NicoSorren/Extrusora-Filamento-PET/PET_Extruder/diagrama_main_loop.pdf

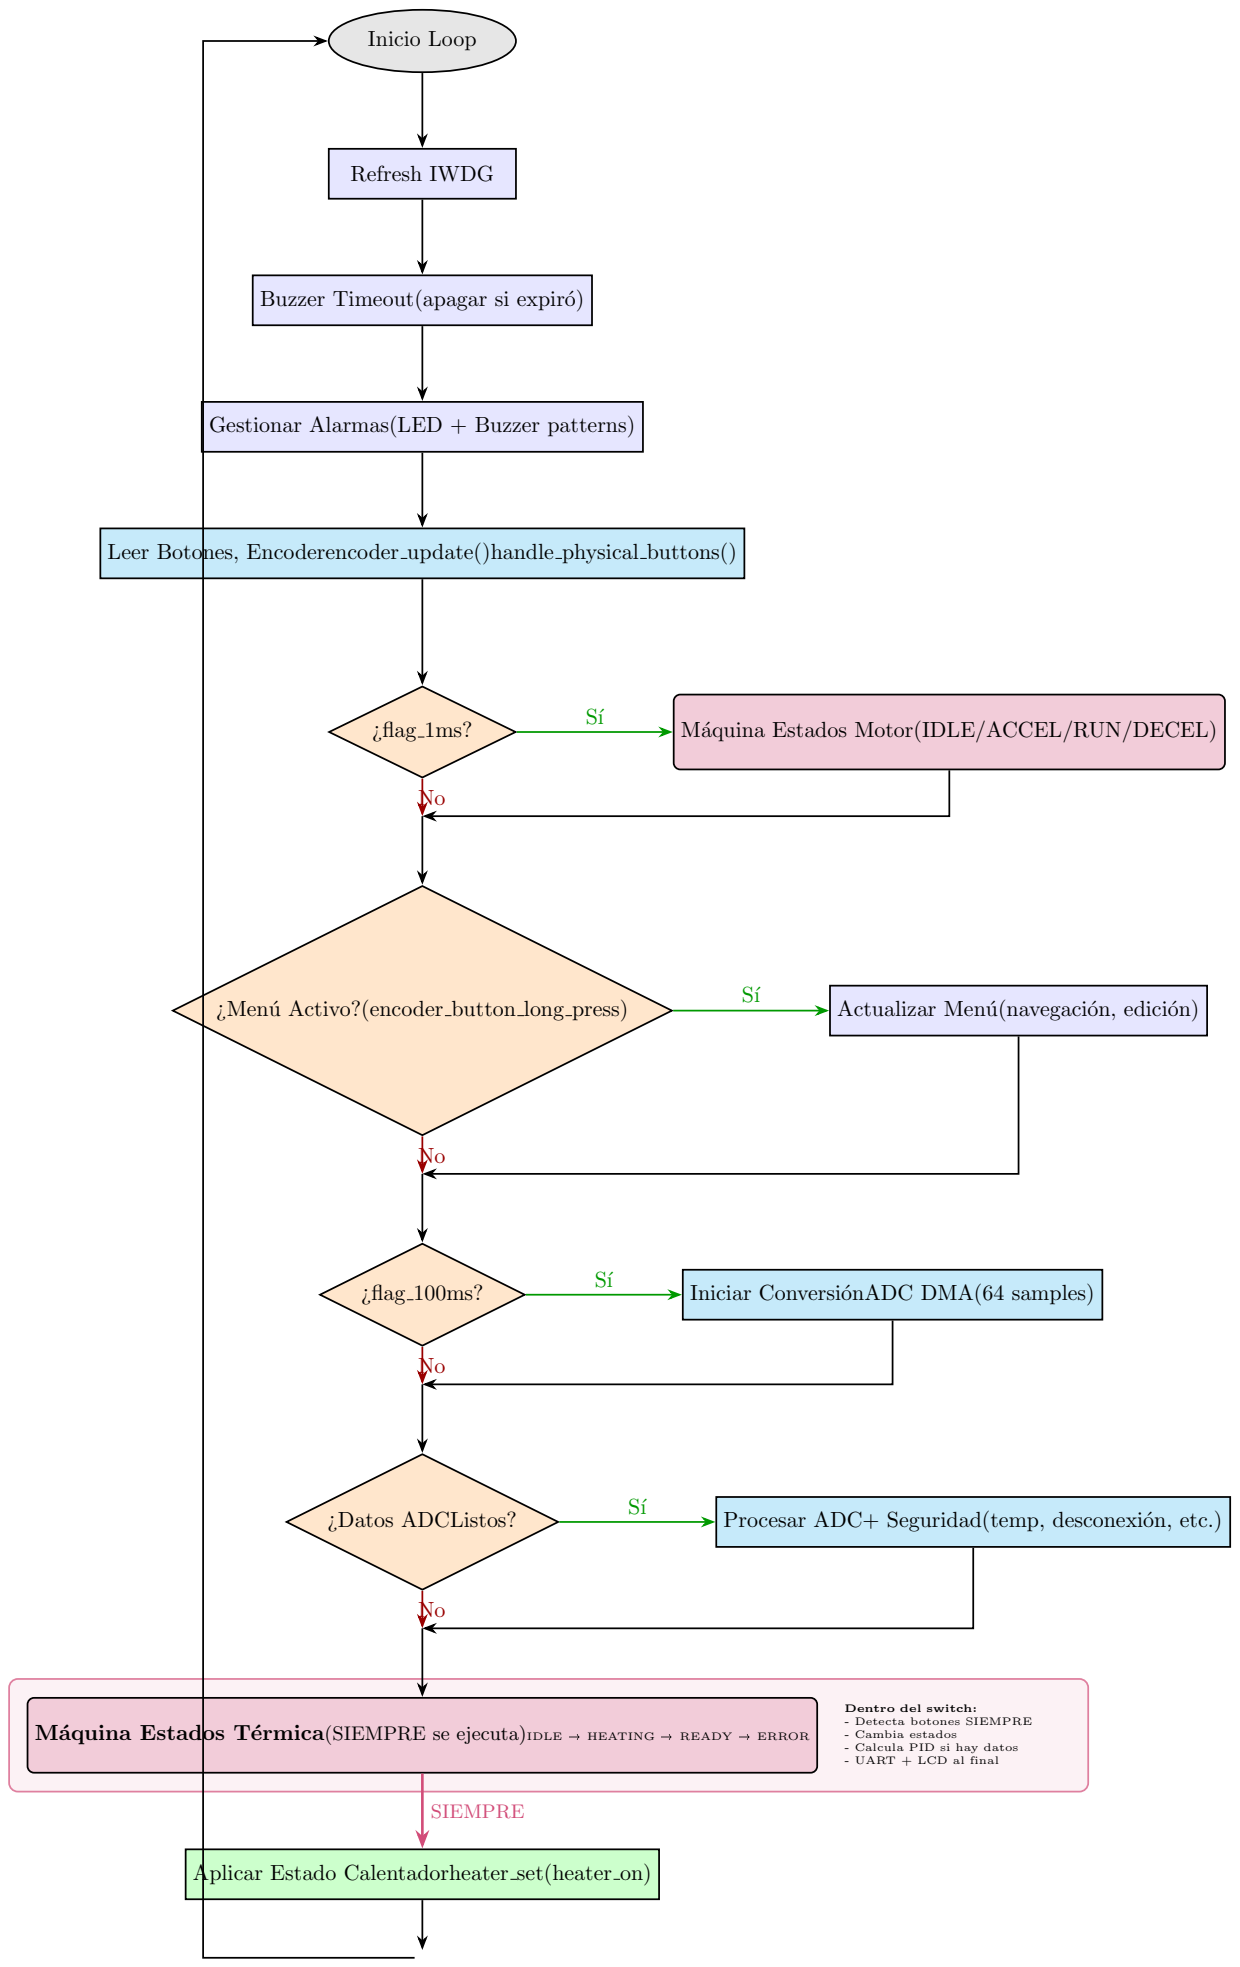
[picture p4: page 1]
Inicio Loop; Refresh IWDG; ¿flag 1ms?; M´aquina Estados Motor(IDLE/ACCEL/RUN/DECEL); ¿Men´u Activo?(encoder button long press); Actualizar Men´u(navegaci´on, edici´on); ¿flag 100ms?; Iniciar Conversi´onADC DMA(64 samples); ¿Datos ADCListos?; Procesar ADC+ Seguridad(temp, desconexi´on, etc.); SIEMPRE

Buzzer Timeout(apagar si expir´o)

Gestionar Alarmas(LED + Buzzer patterns)

Leer Botones, Encoderencoder update()handle physical buttons()

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

M´aquina Estados T´ermica(SIEMPRE se ejecuta)IDLE  HEATING  READY  ERROR

Aplicar Estado Calentadorheater set(heater on)
