NicoSorren/Extrusora-Filamento-PET/PET_Extruder/Core/Inc/main.h

#define DIR_Pin GPIO_PIN_1
#define DIR_GPIO_Port GPIOA
#define BUZZER_Pin GPIO_PIN_2
#define BUZZER_GPIO_Port GPIOA
#define RGB_B_Pin GPIO_PIN_3
#define RGB_B_GPIO_Port GPIOA
#define START_BTN_Pin GPIO_PIN_4
#define START_BTN_GPIO_Port GPIOA
#define MOTOR_EN_Pin GPIO_PIN_5
#define MOTOR_EN_GPIO_Port GPIOA
#define RGB_R_Pin GPIO_PIN_0
#define RGB_R_GPIO_Port GPIOB
#define RGB_G_Pin GPIO_PIN_1
#define RGB_G_GPIO_Port GPIOB
#define HEATER_BTN_Pin GPIO_PIN_11
#define HEATER_BTN_GPIO_Port GPIOB
#define STOP_BTN_Pin GPIO_PIN_12
#define STOP_BTN_GPIO_Port GPIOB
#define ENC_SW_Pin GPIO_PIN_13
#define ENC_SW_GPIO_Port GPIOB
#define ENC_SW_EXTI_IRQn EXTI15_10_IRQn
#define ENC_CLK_Pin GPIO_PIN_14
#define ENC_CLK_GPIO_Port GPIOB
#define ENC_CLK_EXTI_IRQn EXTI15_10_IRQn
#define ENC_DT_Pin GPIO_PIN_15
#define ENC_DT_GPIO_Port GPIOB
#define DRV_FAULT_Pin GPIO_PIN_11
#define DRV_FAULT_GPIO_Port GPIOA
#define DRV_FAULT_EXTI_IRQn EXTI15_10_IRQn
#define HEATER_EN_Pin GPIO_PIN_8
#define HEATER_EN_GPIO_Port GPIOB
