NicoSorren/Extrusora-Filamento-PET/ptf/Core/Src/main1.c

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
/* Includes ------------------------------------------------------------------*/
#include "main.h"

/* USER CODE BEGIN Includes */
#include "st7789.h"
#include "fonts.h"
#include "Menu.h"
#include <stdint.h>
#include "Thermistor.h"
#include "Buzzer.h"
#include "pid.h"
/* USER CODE END Includes */

/* USER CODE BEGIN PD */

volatile int32_t previous_counter=0;
volatile int32_t counterx=0;
volatile int32_t countery=0;
volatile int8_t ESW_Flag=0;//Encoder Switch Flag

uint16_t adc_value = 0;  //Variables For Reading The Thermistor
float temperature = 0.0;

volatile uint8_t page=0;//For Navigating The Menu
volatile uint8_t edit_mode = 0;// Flags...
volatile uint8_t START_flag = 0;
volatile uint8_t Heat_flag = 0;
volatile uint8_t Heat_Start_Flag=0;
volatile uint8_t protection_flag=0;

uint16_t Target_Temperature=260; // Memory Temp
uint8_t  Speed=50; // Memory Speed
uint8_t  Buzzer_State=1; // Memory Buzzer State
uint8_t  Switch_State=0; // Memory Switch State

uint8_t END_STOP_FLAG=0;// Filament run out detection flag

PID_TypeDef HeaterPID;
double input_temp, output_pwm, setpoint_temp;

/* USER CODE END PD */

ADC_HandleTypeDef hadc;

SPI_HandleTypeDef hspi1;
DMA_HandleTypeDef hdma_spi1_tx;

TIM_HandleTypeDef htim1;
TIM_HandleTypeDef htim2;
TIM_HandleTypeDef htim3;

void SystemClock_Config(void);
static void MX_GPIO_Init(void);
static void MX_DMA_Init(void);
static void MX_SPI1_Init(void);
static void MX_TIM1_Init(void);
static void MX_ADC_Init(void);
static void MX_TIM2_Init(void);
static void MX_TIM3_Init(void);
/* USER CODE BEGIN 0 */

void HAL_TIM_IC_CaptureCallback(TIM_HandleTypeDef *htim) //Reading Rotary Encoder...
{
    if (htim->Instance == TIM2) {

       int32_t current_counter = __HAL_TIM_GET_COUNTER(htim);
       int32_t delta = current_counter - previous_counter;

		if (delta > 32767) delta -= 65536;
		else if (delta < -32768) delta += 65536;

		counterx += delta;
		countery = counterx/2;
		previous_counter = current_counter;

		if(page==1 && START_flag==0 && Heat_flag==0){
		   if(countery>2){ countery=0; counterx=0;}
		   if(countery<0){ countery=2; counterx=2*2;}
		   mm_selection_indicator(countery);  // Update indicator
		}

		if(page==1 && START_flag==0 && Heat_flag==1){
			if (countery > 1) { countery = 0; counterx = 0; }
			if (countery < 0) { countery = 1; counterx = 1 * 2; }
			mm_selection_indicator(countery); // Update indicator
		}

        if(page==2 && edit_mode==0){
            if (countery > 4) { countery = 0; counterx = 0; }
            if (countery < 0) { countery = 4; counterx = 4 * 2; }
            sm_selection_indicator(countery); // Update indicator
        }
}    }

void HAL_GPIO_EXTI_Callback(uint16_t GPIO_Pin) //Reading Button...
{

	 if (GPIO_Pin == GPIO_PIN_2) // PA2 = EXTI2
	    {
	        static uint32_t last_press = 0;
	        uint32_t now = HAL_GetTick();

	        if (now - last_press > 200)
	        {
	            ESW_Flag = 1;
	            last_press = now;
	        }
	    }

}

void Stepper_SetSpeed(uint8_t speed) {// Adjust the PWM frequency to control the stepper
    uint32_t freq = speed * 10;// Value we read from the menu * 10
    uint32_t timer_clock = 48000000; // 48 MHz system clock!!
    uint32_t prescaler = 48 - 1;     // 1 MHz timer tick
    uint32_t period = (1000000 / freq) - 1;

    __HAL_TIM_SET_PRESCALER(&htim1, prescaler);
    __HAL_TIM_SET_AUTORELOAD(&htim1, period);
    __HAL_TIM_SET_COMPARE(&htim1, TIM_CHANNEL_2, period / 2); // 50% duty
}

void Stepper_SoftStart(uint8_t targetSpeed)// Soft starting stepper
{
    uint8_t currentSpeed = 2;  // starting from very slow
    uint8_t step = 2;           // speed increment per step
    uint8_t delay = 50;         // ms delay between increments

    while (currentSpeed < targetSpeed)
    {
        Stepper_SetSpeed(currentSpeed);
        HAL_TIM_PWM_Start(&htim1, TIM_CHANNEL_2);
        HAL_Delay(delay);
        currentSpeed += step;
    }

    // Final target speed
    Stepper_SetSpeed(targetSpeed);
}

void Heater_SetPower(float duty)// Control the PWM of the MOSFET...
{
    // Clamp duty cycle between 0–100%
    if (duty < 0.0f) duty = 0.0f;
    if (duty > 100.0f) duty = 100.0f;

    // Get the timer period (ARR)
    uint32_t period = __HAL_TIM_GET_AUTORELOAD(&htim3);

    // Calculate the compare value based on duty %
    uint32_t compare = (uint32_t)((duty / 100.0f) * period);

    // Apply new PWM duty
    __HAL_TIM_SET_COMPARE(&htim3, TIM_CHANNEL_1, compare);
}


/* USER CODE END 0 */

/**
  * @brief  The application entry point.
  * @retval int
  */
int main(void)
{

  /* MCU Configuration--------------------------------------------------------*/

  /* Reset of all peripherals, Initializes the Flash interface and the Systick. */
  HAL_Init();

  /* Configure the system clock */
  SystemClock_Config();

  /* Initialize all configured peripherals */
  MX_GPIO_Init();
  MX_DMA_Init();
  MX_SPI1_Init();
  MX_TIM1_Init();
  MX_ADC_Init();
  MX_TIM2_Init();
  MX_TIM3_Init();
  /* USER CODE BEGIN 2 */
  HAL_TIM_Encoder_Start_IT(&htim2, TIM_CHANNEL_ALL);
  HAL_TIM_PWM_Start(&htim3, TIM_CHANNEL_1);
  ST7789_Init();
  opening_melody();// Play the melody while opening
  main_menu();// Call the main menu

  HAL_GPIO_WritePin(DIR_GPIO_Port, DIR_Pin, 1); //Direction of the stepper...
  HAL_GPIO_WritePin(EN_GPIO_Port, EN_Pin, 1);// Disable stepper driver...

  setpoint_temp = Target_Temperature;   // Desired temp (°C)
  input_temp = temperature;              // Initial temperature reading
  output_pwm = 0.0;                      // Start with no heater power

  PID(&HeaterPID, &input_temp, &output_pwm, &setpoint_temp,
      0.8, 0.006, 0.7,                   // Tune for better results...
      _PID_P_ON_E, _PID_CD_DIRECT);     // Standard direct control

  PID_SetOutputLimits(&HeaterPID, 0, 100);    // PWM % output limit
  PID_SetMode(&HeaterPID, _PID_MODE_AUTOMATIC);

  /* USER CODE END 2 */

  /* Infinite loop */
  /* USER CODE BEGIN WHILE */
  while (1)
  {

	HAL_Delay(250);


	END_STOP_FLAG = HAL_GPIO_ReadPin(EndSW_GPIO_Port, EndSW_Pin);
	adc_value = Read_ADC_Channel(&hadc);
	temperature = Get_Temperature(adc_value);

	if(page==1){ // Refresh the readings once in a while
	mm_values((uint16_t)temperature, Target_Temperature, Speed);
	}
	if(page==2){ // Refresh the readings once in a while
	settings_values(Target_Temperature, Speed, Buzzer_State, Switch_State);
	}


/*--------------------------------------------------------------------------------*/
// Main Menu Section
/*--------------------------------------------------------------------------------*/// Start Option
	if((ESW_Flag==1 && countery==0 && page==1 && Heat_flag==0 && START_flag==0) || Heat_Start_Flag==1){   //START
		ESW_Flag=0;
		Heat_Start_Flag=0;
		START_flag=1;
		HAL_GPIO_WritePin(EN_GPIO_Port, EN_Pin, 0);// Enable stepper driver
		ST7789_WriteString(60, 135, "Starting", Font_16x26, WHITE, BLACK);
		start_melody();
		ST7789_WriteString(60, 135, "        ", Font_16x26, WHITE, BLACK);
		if(temperature >= Target_Temperature - 10){
		Stepper_SoftStart(Speed);
		}

	}
	if(START_flag==1){
		ST7789_WriteString(88, 135, "Stop ", Font_16x26, WHITE, BLACK);

		adc_value = Read_ADC_Channel(&hadc);
		temperature = Get_Temperature(adc_value);
		mm_values((uint16_t)temperature, Target_Temperature, Speed);

		input_temp = temperature;             // Current temperature
		setpoint_temp = Target_Temperature;   // Target

		if (PID_Compute(&HeaterPID))
		{
		    Heater_SetPower(output_pwm);      // Apply PID output to heater PWM

		}

		if(temperature >= Target_Temperature - 4){ // If the measured temperature is bigger then target only than start the stepper...
		Stepper_SetSpeed(Speed);
		HAL_TIM_PWM_Start(&htim1, TIM_CHANNEL_2);
		protection_flag=1;
		}

		if((temperature <= Target_Temperature - 15) && protection_flag==1){ // PID values might be too small or there might be a heating problem, stop the stepper...
		protection_flag=0;
		}

		if((END_STOP_FLAG == 0 && Switch_State == 1) || protection_flag==0 ){ // If the filament runs out or nozzle too cold

			START_flag = 0;// Stop the machine when the filament runs out

			__HAL_TIM_SET_COUNTER(&htim2, 0);
			counterx = 0;
			countery = 0;
			previous_counter = 0;
			mm_selection_indicator(countery);

			HAL_TIM_PWM_Stop(&htim1, TIM_CHANNEL_2);     //Stop stepper
            HAL_GPIO_WritePin(EN_GPIO_Port, EN_Pin, 1);

            Heater_SetPower(0); //Stop heater
            output_pwm = 0.0;
            ST7789_WriteString(80, 135, "Start", Font_16x26, WHITE, BLACK);
            stop_melody();

		}


		if (ESW_Flag == 1) { // If user clicks Stop
			ESW_Flag = 0;
			START_flag = 0;

			__HAL_TIM_SET_COUNTER(&htim2, 0);
			counterx = 0;
			countery = 0;
			previous_counter = 0;
			mm_selection_indicator(countery);

		    HAL_TIM_PWM_Stop(&htim1, TIM_CHANNEL_2);     //Stop stepper
			HAL_GPIO_WritePin(EN_GPIO_Port, EN_Pin, 1);

			Heater_SetPower(0); //Stop heater
			output_pwm = 0.0;

			ST7789_WriteString(80, 135, "Start", Font_16x26, WHITE, BLACK);
			short_stop_melody();
    }}

/*--------------------------------------------------------------------------------*/// Pre-heat Option
	if(ESW_Flag==1 && countery==1 && page==1 && START_flag==0 && Heat_flag==0){  // Enter Pre-Heat mode
	    ESW_Flag=0;
	    Heat_flag=1;
	    ST7789_WriteString(56, 170, "  ", Font_16x26, WHITE, BLACK);
	    ST7789_WriteString(76, 170, "Cancel ", Font_16x26, WHITE, BLACK);
	    start_melody();
	}
	if (Heat_flag == 1) {

		input_temp = temperature;             // Current temperature
		setpoint_temp = Target_Temperature;   // Target

		if (PID_Compute(&HeaterPID))
		{
			Heater_SetPower(output_pwm);      // Apply PID output to heater PWM
		}

		if(temperature>=Target_Temperature - 4){
			protection_flag=1;
		}

	    if (ESW_Flag == 1 && countery == 0) { // Start
	    	ST7789_WriteString(56, 170, "Pre-Heat", Font_16x26, WHITE, BLACK);
	    	Heat_Start_Flag=1;
	    	ESW_Flag=0;
	        Heat_flag = 0;
	        START_flag = 1;

	        __HAL_TIM_SET_COUNTER(&htim2, 0);
	        counterx = 0;
	        countery = 0;
	        previous_counter = 0;
	        mm_selection_indicator(countery);
	    }

	    if (ESW_Flag == 1 && countery == 1) { // Cancel
	        ESW_Flag = 0;
	        Heat_flag = 0;

	        Heater_SetPower(0); //Stop heater
	        output_pwm = 0.0;

			__HAL_TIM_SET_COUNTER(&htim2, 0);
			counterx = 0;
			countery = 0;
			previous_counter = 0;
			mm_selection_indicator(countery);

	        ST7789_WriteString(56, 170, "Pre-Heat", Font_16x26, WHITE, BLACK);
	        short_stop_melody();
	}}

/*--------------------------------------------------------------------------------*/// Settings Option
	if(ESW_Flag==1 && countery==2 && page==1){  //Settings
	   ESW_Flag=0;
	   START_flag=0;
	   Heat_flag=0;
	   settings_melody();
	   settings_menu();

	   __HAL_TIM_SET_COUNTER(&htim2, 0);  // Reset encoder hardware counter
	   previous_counter = 0;
	   counterx = 0;
	   countery = 0;

    }



/*--------------------------------------------------------------------------------*/
// Settings Menu Section
/*--------------------------------------------------------------------------------*/// Temperature Edit
	if (ESW_Flag == 1 && countery == 0 && page == 2) {  // Temp edit mode
	    ESW_Flag = 0;
	    edit_mode = 1;

	    uint16_t temp_edit = Target_Temperature;  // Start from current
	    int16_t base_counter = countery;           // Remember where encoder was

	    while (edit_mode == 1) {
	    	HAL_Delay(100);
	        // Calculate movement relative to entry position
	        int16_t diff = countery - base_counter;

	        if (diff != 0) {
	            temp_edit += diff;        // apply movement
	            base_counter = countery;  // update baseline
	        }

	        if (temp_edit > 260) temp_edit = 260; // Clamp value to limits
	        if (temp_edit < 180) temp_edit = 180;

	        // Show on screen
	        settings_values(temp_edit, Speed, Buzzer_State, Switch_State);

	        if (ESW_Flag == 1) { // Save if button pressed
	            ESW_Flag = 0;
	            Target_Temperature = temp_edit;
	            edit_mode = 0;
	            counterx = 0;
	            countery = 0;// reset encoder for next use
	}}}

/*--------------------------------------------------------------------------------*/// Speed Edit
	if (ESW_Flag == 1 && countery == 1 && page == 2) {  // Speed edit mode
	    ESW_Flag = 0;
	    edit_mode = 1;

	    uint8_t temp_speed = Speed;       // Start from current Speed
	    int16_t base_counter = countery;  // Remember current encoder position

	    while (edit_mode == 1) {
	        HAL_Delay(100);

	        // Calculate encoder movement
	        int16_t diff = countery - base_counter;

	        if (diff != 0) {
	            temp_speed += diff;        // Adjust speed
	            base_counter = countery;   // Update baseline
	        }

	        // Clamp speed to safe limits
	        if (temp_speed > 100) temp_speed = 100;
	        if (temp_speed < 4)  temp_speed = 4;

	        // Update display live
	        settings_values(Target_Temperature, temp_speed, Buzzer_State, Switch_State);

	        // Save and exit on button press
	        if (ESW_Flag == 1) {
	            ESW_Flag = 0;
	            Speed = temp_speed;
	            edit_mode = 0;
	            counterx = 1*2; // Reset encoder for next use
	            countery = 1;
    }}}

/*--------------------------------------------------------------------------------*/// Buzzer Edit
	if (ESW_Flag == 1 && countery == 2 && page == 2) {  // Buzzer edit
	    ESW_Flag = 0;
	    edit_mode = 1;

	    while (edit_mode == 1) {
	        HAL_Delay(100);

	        // Toggle buzzer with encoder rotation
	        if (countery != 2) {        // user rotated encoder
	            Buzzer_State = !Buzzer_State;
	            countery = 2;           // reset back to its menu slot
	            settings_values(Target_Temperature, Speed, Buzzer_State, Switch_State);
	        }

	        if (ESW_Flag == 1) {// Exit on button press
	            ESW_Flag = 0;
	            edit_mode = 0;
	            counterx = 2*2;
	            countery = 2;
	}}}

/*--------------------------------------------------------------------------------*/// Switch Edit
	if (ESW_Flag == 1 && countery == 3 && page == 2) {  // Switch edit
	    ESW_Flag = 0;
	    edit_mode = 1;

	    while (edit_mode == 1) {
	        HAL_Delay(100);

	        // Toggle switch with encoder rotation
	        if (countery != 3) {        // user rotated encoder
	            Switch_State = !Switch_State;
	            countery = 3;           // reset position
	            settings_values(Target_Temperature, Speed, Buzzer_State, Switch_State);
	        }

	        if (ESW_Flag == 1) {// Exit on button press
	            ESW_Flag = 0;
	            edit_mode = 0;
	            counterx = 4*2;
	            countery = 4;
	 }}}

/*--------------------------------------------------------------------------------*/// Save and go back to main menu
	if(ESW_Flag==1 && countery==4 && page==2){  //Save & Back
	   ESW_Flag=0;
	   settings_melody();
	   main_menu();
	   __HAL_TIM_SET_COUNTER(&htim2, 0);  // Reset encoder hardware counter
	   previous_counter = 0;
	   counterx = 0;
	   countery = 0;
	}


    /* USER CODE END WHILE */

    /* USER CODE BEGIN 3 */
  }
  /* USER CODE END 3 */
}

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
