NicoSorren/Extrusora-Filamento-PET/ptf/Core/Inc/Buzzer.h

/*
 * Buzzer.h
 *
 *  Created on: Nov 10, 2025
 *      Author: Alper
 */

#ifndef INC_BUZZER_H_
#define INC_BUZZER_H_


void opening_melody();
void start_melody();
void stop_melody();
void short_stop_melody();
void settings_melody();
#endif /* INC_BUZZER_H_ */
