NicoSorren/Extrusora-Filamento-PET/ptf/Core/Src/Buzzer.c

/*
 * Buzzer.c
 *
 *  Created on: Nov 10, 2025
 *      Author: Alper
 */

#include "main.h"


void opening_melody()
{
if(Buzzer_State==1){
    HAL_GPIO_WritePin(Buzzer_GPIO_Port, Buzzer_Pin, GPIO_PIN_SET);
    HAL_Delay(80);
    HAL_GPIO_WritePin(Buzzer_GPIO_Port, Buzzer_Pin, GPIO_PIN_RESET);
    HAL_Delay(40);

    HAL_GPIO_WritePin(Buzzer_GPIO_Port, Buzzer_Pin, GPIO_PIN_SET);
    HAL_Delay(80);
    HAL_GPIO_WritePin(Buzzer_GPIO_Port, Buzzer_Pin, GPIO_PIN_RESET);
    HAL_Delay(40);

    HAL_GPIO_WritePin(Buzzer_GPIO_Port, Buzzer_Pin, GPIO_PIN_SET);
    HAL_Delay(100);
    HAL_GPIO_WritePin(Buzzer_GPIO_Port, Buzzer_Pin, GPIO_PIN_RESET);
    HAL_Delay(50);

    HAL_GPIO_WritePin(Buzzer_GPIO_Port, Buzzer_Pin, GPIO_PIN_SET);
    HAL_Delay(150);
    HAL_GPIO_WritePin(Buzzer_GPIO_Port, Buzzer_Pin, GPIO_PIN_RESET);
}}


void start_melody(){
	if(Buzzer_State==1){
	HAL_GPIO_WritePin(Buzzer_GPIO_Port, Buzzer_Pin, GPIO_PIN_SET);
	HAL_Delay(50);
	HAL_GPIO_WritePin(Buzzer_GPIO_Port, Buzzer_Pin, GPIO_PIN_RESET);
	HAL_Delay(50);
	HAL_GPIO_WritePin(Buzzer_GPIO_Port, Buzzer_Pin, GPIO_PIN_SET);
	HAL_Delay(50);
	HAL_GPIO_WritePin(Buzzer_GPIO_Port, Buzzer_Pin, GPIO_PIN_SET);
	HAL_Delay(50);
	HAL_GPIO_WritePin(Buzzer_GPIO_Port, Buzzer_Pin, GPIO_PIN_RESET);
}}

void settings_melody(){
	HAL_GPIO_WritePin(Buzzer_GPIO_Port, Buzzer_Pin, GPIO_PIN_SET);
	HAL_Delay(50);
	HAL_GPIO_WritePin(Buzzer_GPIO_Port, Buzzer_Pin, GPIO_PIN_RESET);
	HAL_Delay(50);
}

void stop_melody(){
	if(Buzzer_State==1){
	HAL_GPIO_WritePin(Buzzer_GPIO_Port, Buzzer_Pin, GPIO_PIN_SET);
    HAL_Delay(500);
    HAL_GPIO_WritePin(Buzzer_GPIO_Port, Buzzer_Pin, GPIO_PIN_RESET);
    HAL_Delay(1000);

	HAL_GPIO_WritePin(Buzzer_GPIO_Port, Buzzer_Pin, GPIO_PIN_SET);
    HAL_Delay(500);
    HAL_GPIO_WritePin(Buzzer_GPIO_Port, Buzzer_Pin, GPIO_PIN_RESET);
    HAL_Delay(1000);

	HAL_GPIO_WritePin(Buzzer_GPIO_Port, Buzzer_Pin, GPIO_PIN_SET);
    HAL_Delay(500);
    HAL_GPIO_WritePin(Buzzer_GPIO_Port, Buzzer_Pin, GPIO_PIN_RESET);
    HAL_Delay(1000);
}}

void short_stop_melody(){
	if(Buzzer_State==1){
	HAL_GPIO_WritePin(Buzzer_GPIO_Port, Buzzer_Pin, GPIO_PIN_SET);
	HAL_Delay(50);
	HAL_GPIO_WritePin(Buzzer_GPIO_Port, Buzzer_Pin, GPIO_PIN_RESET);
	HAL_Delay(100);
	HAL_GPIO_WritePin(Buzzer_GPIO_Port, Buzzer_Pin, GPIO_PIN_SET);
	HAL_Delay(50);
	HAL_GPIO_WritePin(Buzzer_GPIO_Port, Buzzer_Pin, GPIO_PIN_RESET);
	HAL_Delay(100);
	HAL_GPIO_WritePin(Buzzer_GPIO_Port, Buzzer_Pin, GPIO_PIN_SET);
	HAL_Delay(50);
	HAL_GPIO_WritePin(Buzzer_GPIO_Port, Buzzer_Pin, GPIO_PIN_RESET);
	HAL_Delay(100);
}}
