NicoSorren/Extrusora-Filamento-PET/Temp_Prueba/Core/Src/main.c

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
/* Includes ------------------------------------------------------------------*/
#include "main.h"
#include "adc.h"
#include "dma.h"
#include "i2c.h"
#include "tim.h"
#include "usart.h"
#include "gpio.h"

/* USER CODE BEGIN Includes */
#include "i2c-lcd.h"
#include <stdio.h>
#include <math.h>
#include <string.h>
#include <stdbool.h>
/* USER CODE END Includes */

/* USER CODE BEGIN PD */
// --- NTC y divisor (pull-up: Rfix a 3.3V, NTC a GND) ---
#define VREF    3.3f
#define ADCMAX  4095.0f
#define RFIX    1000.0f      // 10kΩ a 3.3V
#define R0_NTC  100000.0f     // 100kΩ @ 25°C
#define T0_K    298.15f       // 25°C
#define BETA    3950.0f       // típico B3950

// --- Parámetros de control térmico ---
#define TEMP_TARGET  245      // Setpoint (°C) - Formato entero para UART
#define HYST         2        // Histéresis (°C)
#define TEMP_MAX     270      // Corte por seguridad (°C)

// --- Configuración DMA ---
#define ADC_SAMPLES 32        // Cantidad de muestras por lectura
/* USER CODE END PD */

/* USER CODE BEGIN PM */
static inline float adc_to_voltage(uint16_t adc) { return (adc * VREF) / ADCMAX; }
static inline void heater_set(bool on) {
  HAL_GPIO_WritePin(HEATER_EN_GPIO_Port, HEATER_EN_Pin, on ? GPIO_PIN_SET : GPIO_PIN_RESET);
}
/* USER CODE END PM */


/* USER CODE BEGIN PV */
volatile uint8_t flag_100ms = 0;   // Solo usamos esta flag
static float v_filt = 0.0f;                                     

volatile uint16_t adc_buffer[ADC_SAMPLES]; 
volatile bool adc_conversion_complete = false; 

// --- UART Debug ---
char uart_buffer[128];  // Buffer para mensajes UART

/* USER CODE END PV */

void SystemClock_Config(void);
/* USER CODE BEGIN PFP */
static uint16_t process_adc_buffer(void);
static float    ntc_temp_c_from_adc(uint16_t adc);
/* USER CODE END PFP */

/* USER CODE BEGIN 0 */

/* USER CODE BEGIN 0 */

// Esta función es el "Callback". El sistema la llama automáticamente
// cuando el DMA termina de llenar el buffer.
void HAL_ADC_ConvCpltCallback(ADC_HandleTypeDef* hadc) {
    if (hadc->Instance == ADC1) {
        adc_conversion_complete = true; // ¡Avisar al Chef que los datos están listos!
    }
}

// Procesa el buffer lleno (calcula promedio descartando extremos)
// Esto es pura matemática, no toca el hardware, así que es rapidísimo.
static uint16_t process_adc_buffer(void) {
  uint32_t acc = 0; 
  uint16_t vmin = 0xFFFF, vmax = 0;
  
  for (uint8_t i = 0; i < ADC_SAMPLES; i++) {
    uint16_t v = adc_buffer[i];
    if (v < vmin) vmin = v;
    if (v > vmax) vmax = v;
    acc += v;
  }
  
  if (ADC_SAMPLES > 2) { 
      acc -= (vmin + vmax); 
      return (uint16_t)(acc / (ADC_SAMPLES - 2)); 
  }
  return (uint16_t)(acc / ADC_SAMPLES);
}

// ADC -> Voltaje -> R_NTC -> Temperatura (modelo Beta)
static float ntc_temp_c_from_adc(uint16_t adc) {
  float v = adc_to_voltage(adc);
  if (v <= 0.0f || v >= VREF) return NAN;         // fuera de rango → sensor inválido
  float r_ntc = RFIX * (v / (VREF - v));
  float invT  = (1.0f / T0_K) + (1.0f / BETA) * logf(r_ntc / R0_NTC);
  float Tkelvin = 1.0f / invT;
  return Tkelvin - 273.15f;
}
/* USER CODE END 0 */

/**
  * @brief  The application entry point.
  * @retval int
  */
int main(void)
{

  /* MCU Configuration--------------------------------------------------------*/

  /* Reset of all peripherals, Initializes the Flash interface and the Systick. */
  HAL_Init();

  /* Configure the system clock */
  SystemClock_Config();

  /* Initialize all configured peripherals */
  MX_GPIO_Init();
  MX_DMA_Init();
  MX_ADC1_Init();
  MX_I2C1_Init();
  MX_TIM3_Init();
  MX_USART1_UART_Init();
  /* USER CODE BEGIN 2 */
  // Calibración del ADC (F103): una vez antes de medir
  HAL_ADCEx_Calibration_Start(&hadc1);

  // LCD
  lcd_init();
  lcd_clear();
  lcd_put_cur(0,0); lcd_send_string("NTC Bluepill");
  lcd_put_cur(1,0); lcd_send_string("Init...");
  HAL_Delay(800);               // único delay de arranque
  lcd_clear();

  // Timer base con interrupción (tick 1 ms)
  HAL_TIM_Base_Start_IT(&htim3);

  char line1[17], line2[17];
  static float tc_filt = NAN;   // EMA temperatura
  static float tc_disp = NAN;   // último valor mostrado
  static uint32_t t_last = 0;   // último refresh LCD
  static bool heater_on = false;
  v_filt = 0.0f;


  /* USER CODE END 2 */

  /* Infinite loop */
  /* USER CODE BEGIN WHILE */
  while (1)
  {
    // TAREA 1: Disparar la lectura (Trigger)
    if (flag_100ms) {
      flag_100ms = 0;
      // En lugar de leer aquí bloqueando, le decimos al DMA: "Arranca".
      // El CPU sigue de largo inmediatamente.
      HAL_ADC_Start_DMA(&hadc1, (uint32_t*)adc_buffer, ADC_SAMPLES);
    }

    // TAREA 2: Procesar datos cuando estén listos
    if (adc_conversion_complete) {
      adc_conversion_complete = false; // Bajamos la bandera

      // 1) Procesar el buffer (Matemática pura, muy rápido)
      uint16_t adc = process_adc_buffer();

      // 2) Voltaje + EMA (presentación)
      float v  = adc_to_voltage(adc);
      const float alpha_V = 0.10f;          
      v_filt = (1.0f - alpha_V) * v_filt + alpha_V * v;

      // 3) Convertir a °C
      float tc = ntc_temp_c_from_adc(adc);

      // 4) EMA de temperatura
      const float alpha_T = 0.10f;          
      if (isnan(tc_filt)) tc_filt = tc; else tc_filt += alpha_T * (tc - tc_filt);

      // 5) Control ON/OFF con histéresis + seguridad
      bool sensor_ok = !isnan(tc_filt);
      bool overtemp  = sensor_ok && (tc_filt > TEMP_MAX);
      if (!sensor_ok || overtemp) {
        heater_on = false;                  // seguridad
      } else {
        if (!heater_on && (tc_filt <= (TEMP_TARGET - HYST))) heater_on = true;
        else if (heater_on && (tc_filt >= (TEMP_TARGET + HYST))) heater_on = false;
      }
      heater_set(heater_on);

      // 6) Display 
      uint32_t now = HAL_GetTick();
      bool debe_refrescar = isnan(tc_disp)
                         || fabsf(tc_filt - tc_disp) >= 0.10f
                         || (now - t_last) >= 1000;
      if (debe_refrescar) {
        tc_disp = tc_filt; t_last = now;
        
        // Línea 1: Temperatura actual y setpoint
        if (isnan(tc_disp)) 
          snprintf(line1, sizeof(line1), "T:---C S:%dC", TEMP_TARGET);
        else                
          snprintf(line1, sizeof(line1), "T:%.1fC S:%dC", tc_disp, TEMP_TARGET);
        
        // Línea 2: ADC y estado del calefactor
        snprintf(line2, sizeof(line2), "ADC:%4u H:%s", adc, heater_on ? "ON " : "OFF");
        
        lcd_put_cur(0,0); lcd_send_string(line1);
        lcd_put_cur(1,0); lcd_send_string(line2);
      }
    }
  
    /* USER CODE END WHILE */

    /* USER CODE BEGIN 3 */
  }
  /* USER CODE END 3 */
}

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
/* USER CODE BEGIN 4 */
void HAL_TIM_PeriodElapsedCallback(TIM_HandleTypeDef *htim) {
  if (htim->Instance == TIM3) {        // tick = 1 ms
    static uint16_t d100 = 0;
    if (++d100 >= 100) {  // Cada 100 ms
      d100 = 0;  
      flag_100ms = 1;
    }
  }
}
/* USER CODE END 4 */
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
