NicoSorren/Extrusora-Filamento-PET/(commit log)

2025-11-24 Extrusora Filamento PET
2025-11-29 cambio antes de DMA Temp_prueba
2025-11-29 cambios antes de dma
2025-12-10 version antes pwm para heater
    [CONTROL ON OFF 150 °C.csv, CONTROL PID KP 15, KI 0.8, KD 450 .csv, CONTROL PID KP 15, KI 0.8, KD 450.csv, CONTROL PID KP 20, KI 1.5, KD 10..csv, CONTROL PID KP 25, KI 0.8, KD 350.csv, PID_FAIL_NOISE_KICK.csv, extruder_log_2025-12-09_10-22-53.csv, extruder_log_2025-12-09_10-26-01.csv]
2025-12-10 version antes pwm heater
2026-02-02 cambios antes del desastre
    [debug_2026-02-02_14-06-23.csv, debug_2026-02-02_14-13-18.csv, debug_2026-02-02_17-42-14.csv, debug_2026-02-02_17-55-44.csv, debug_2026-02-02_18-01-34.csv, debug_2026-02-02_18-09-48.csv, debug_2026-02-02_18-11-05.csv, debug_2026-02-02_18-19-28.csv]
2026-02-04 version final
    [safety_events_2026-02-04_11-17-29.csv, safety_events_2026-02-04_11-27-44.csv, safety_events_2026-02-04_11-43-58.csv, safety_events_2026-02-04_11-54-46.csv, safety_events_2026-02-04_11-55-52.csv, telemetry_2026-02-04_11-17-29.csv, telemetry_2026-02-04_11-27-44.csv, telemetry_2026-02-04_11-43-58.csv]
2026-02-07 Version final finalissima
    [safety_events_2026-02-05_13-02-49.csv, safety_events_2026-02-05_13-23-33.csv, safety_events_2026-02-05_13-28-38.csv, telemetry_2026-02-05_13-02-49.csv, telemetry_2026-02-05_13-23-33.csv, telemetry_2026-02-05_13-28-38.csv]
2026-02-11 prueba errores (pwm)
    [safety_events_2026-02-10_17-03-25.csv, safety_events_2026-02-10_17-21-34.csv, safety_events_2026-02-10_18-41-56.csv, safety_events_2026-02-10_19-58-06.csv, safety_events_2026-02-10_20-05-17.csv, safety_events_2026-02-11_00-28-44.csv, safety_events_2026-02-11_00-40-50.csv, telemetry_2026-02-10_17-03-25.csv]
