NicoSorren/Extrusora-Filamento-PET/(notices)

Notices in the files:
PET_Extruder/Core/Inc/main.h:
Copyright (c) 2025 STMicroelectronics.
All rights reserved.
This software is licensed under terms that can be found in the LICENSE file
